aadarshkumar-singh/movementdetectionusingradar/20_SW/Workspace_SDHD_FreeSoc2/SDHD_MovementDetection.cydsn/docs/hardware_setup.jpg

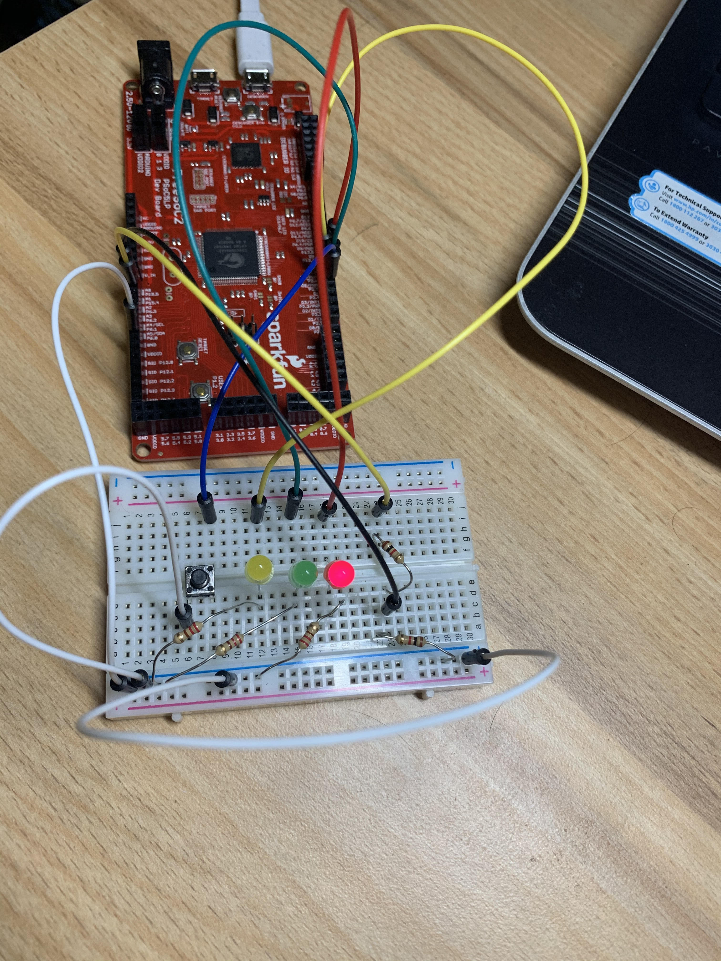
20_SW/Workspace_SDHD_FreeSoc2/SDHD_MovementDetection.cydsn/docs/hardware_setup.jpg
