aadarshkumar-singh/movementdetectionusingradar/60_Report/part_3_implementing_on_hardware/3D_SideView.png

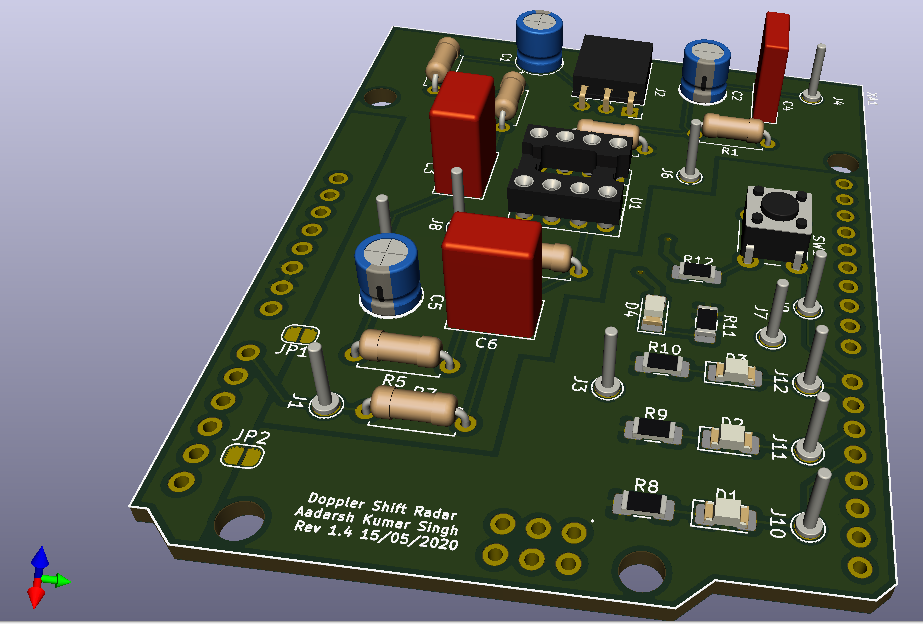
60_Report/part_3_implementing_on_hardware/3D_SideView.png
