aadarshkumar-singh/movementdetectionusingradar/60_Report/part_2_Software_Assignment/Statemachine.pdf

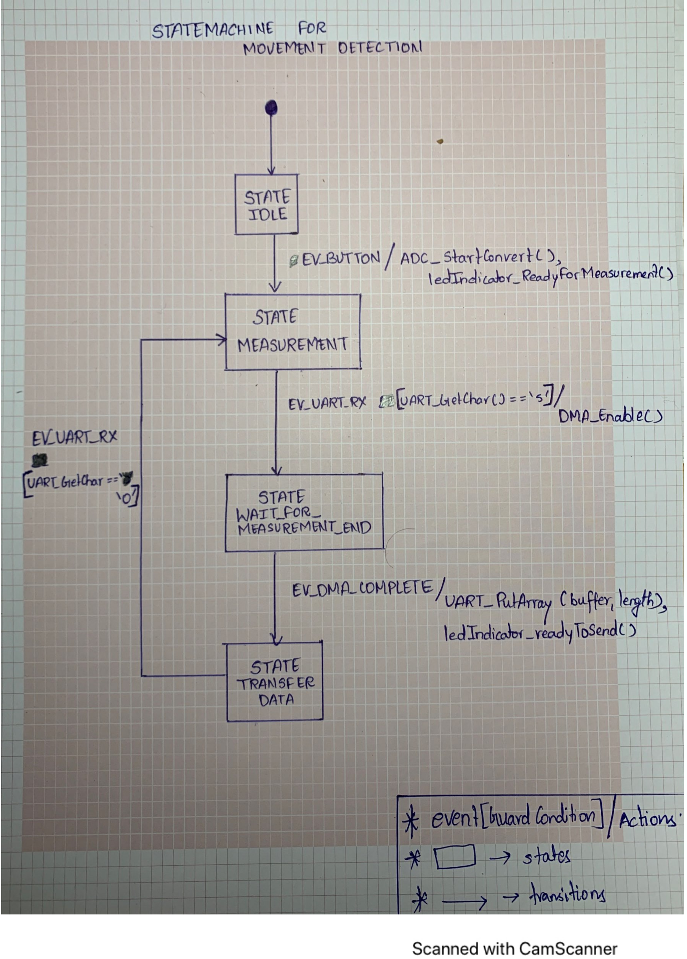
[picture p13: page 1]
