aadarshkumar-singh/movementdetectionusingradar/20_SW/Workspace_SDHD_FreeSoc2/SDHD_MovementDetection.cydsn/matlab/screenshots/Improvement/_Vout2_autoIncrement_f_100Hz.png

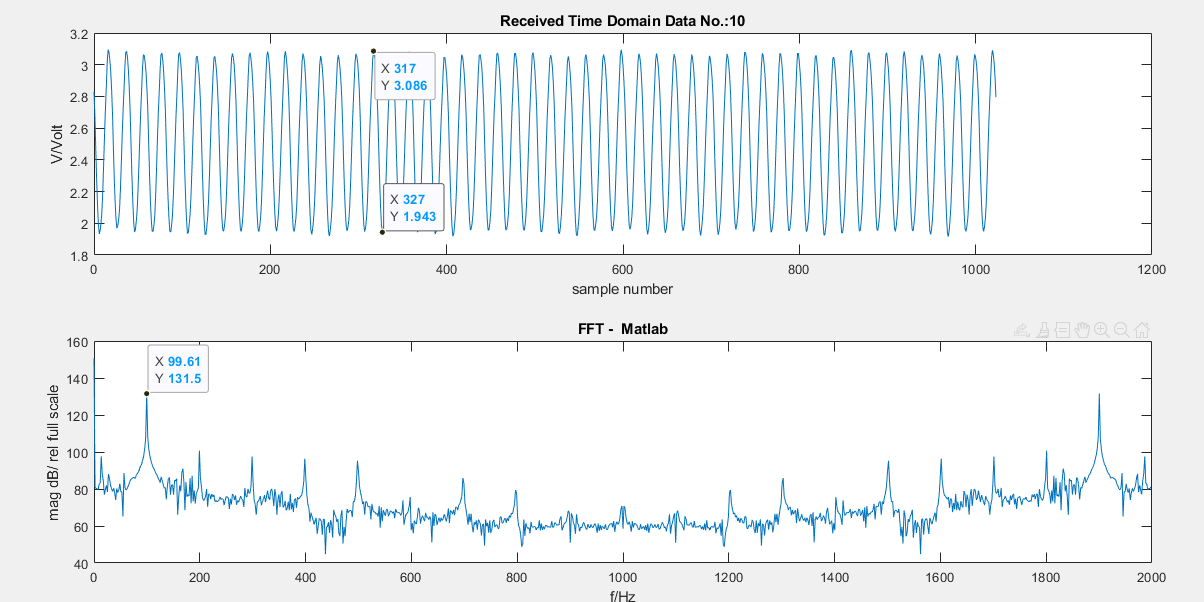
20_SW/Workspace_SDHD_FreeSoc2/SDHD_MovementDetection.cydsn/matlab/screenshots/Improvement/_Vout2_autoIncrement_f_100Hz.png
