aadarshkumar-singh/movementdetectionusingradar/20_SW/Workspace_SDHD_FreeSoc2/SDHD_MovementDetection.cydsn/matlab/screenshots/Improvement/Vout2_autoIncrement_f_50Hz.png

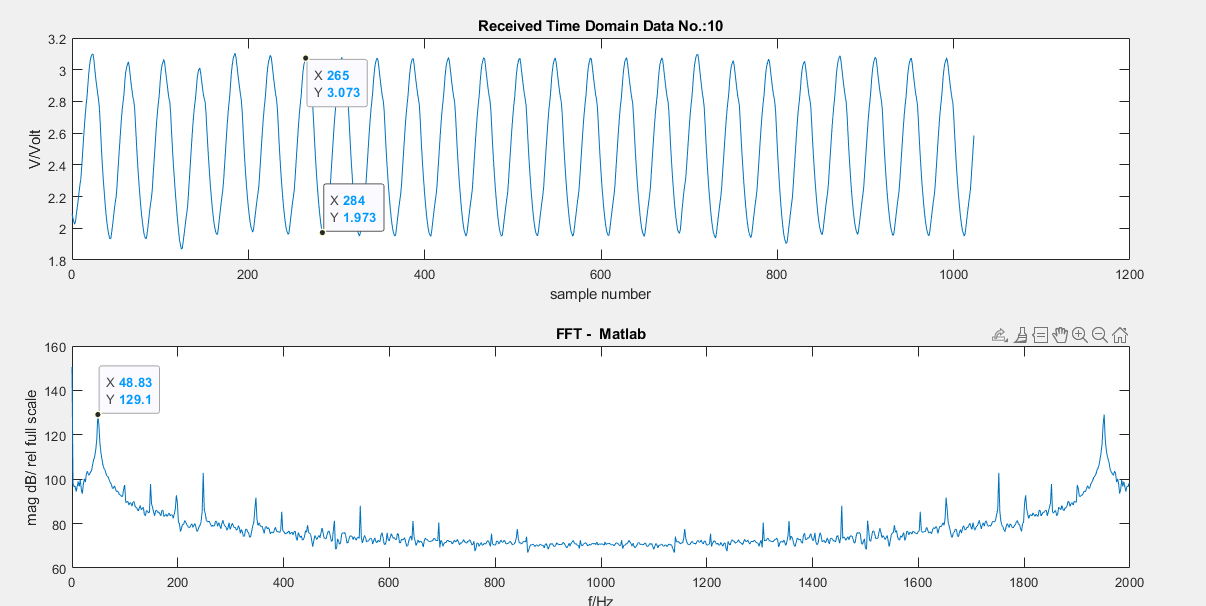
20_SW/Workspace_SDHD_FreeSoc2/SDHD_MovementDetection.cydsn/matlab/screenshots/Improvement/Vout2_autoIncrement_f_50Hz.png
