aadarshkumar-singh/movementdetectionusingradar/20_SW/Workspace_SDHD_FreeSoc2/SDHD_MovementDetection.cydsn/matlab/screenshots/VppForSignals_F_100Hz_Vin_40mV/VinPPValue.png

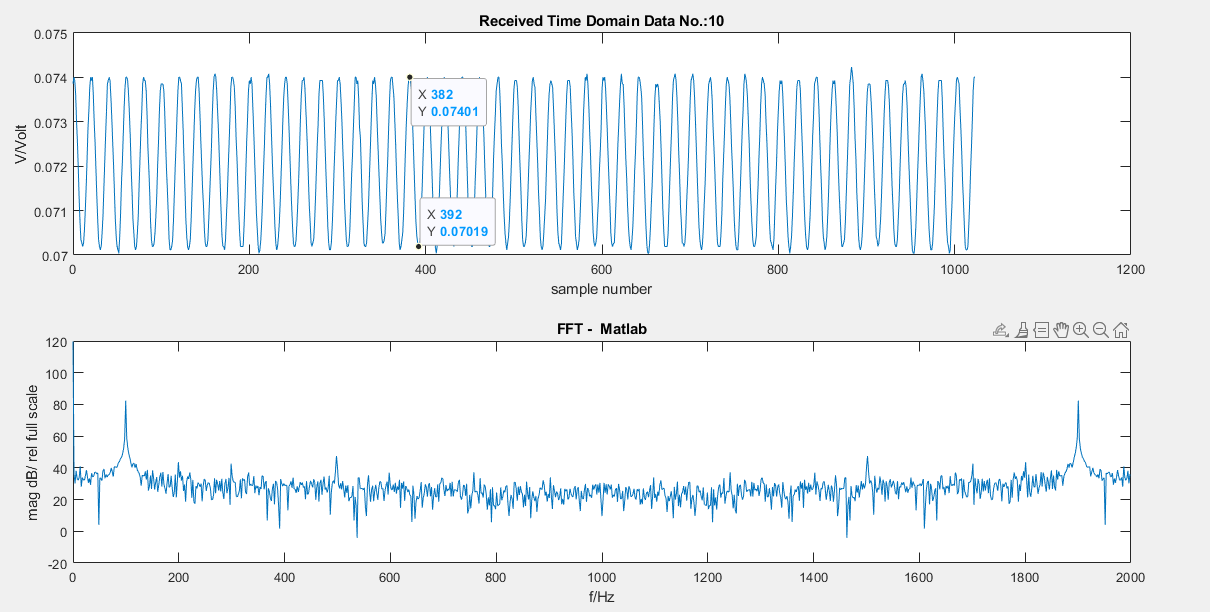
20_SW/Workspace_SDHD_FreeSoc2/SDHD_MovementDetection.cydsn/matlab/screenshots/VppForSignals_F_100Hz_Vin_40mV/VinPPValue.png
