aadarshkumar-singh/movementdetectionusingradar/60_Report/part_3_implementing_on_hardware/pcb_layout.png

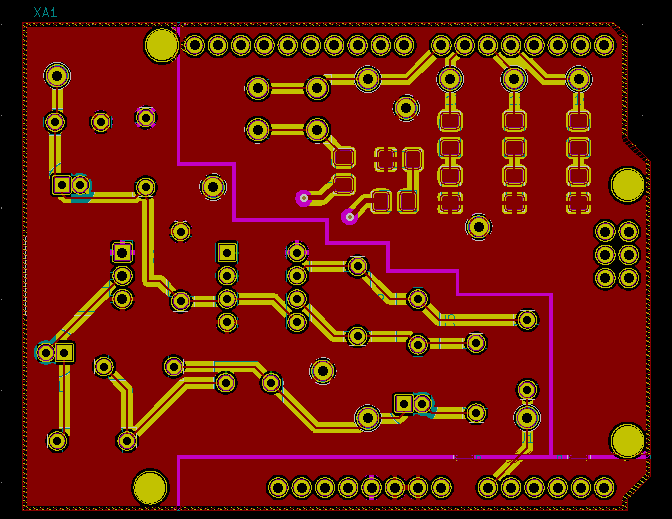
60_Report/part_3_implementing_on_hardware/pcb_layout.png
