aadarshkumar-singh/movementdetectionusingradar/50_Output/Testbench_Vout2pp_diffFreq/_Vout2_autoIncrement_f_150Hz.png

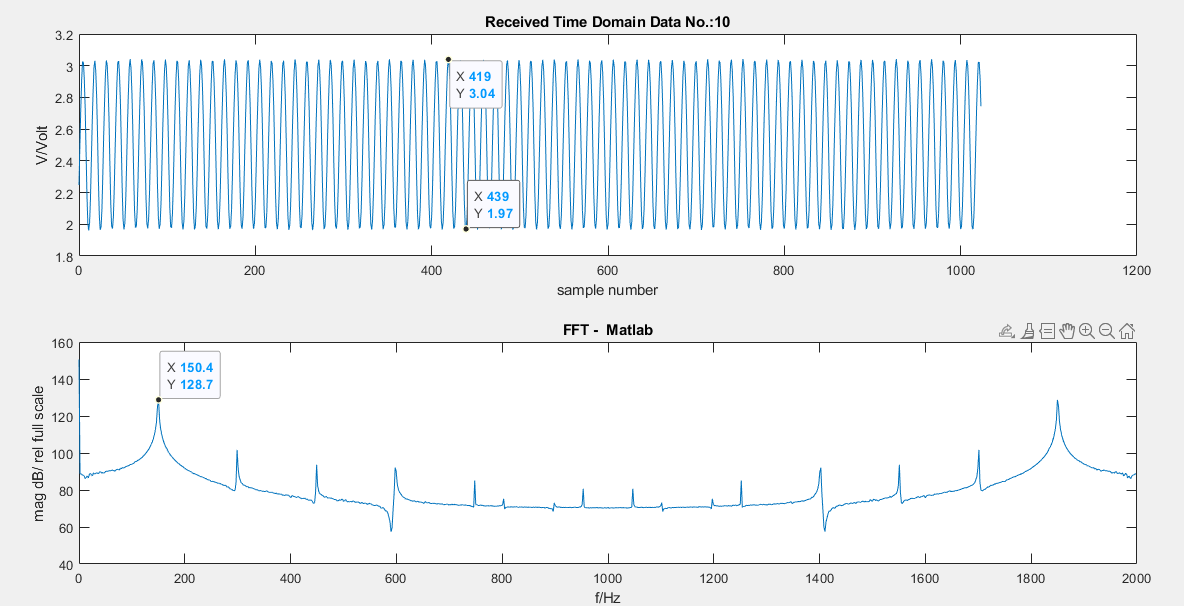
50_Output/Testbench_Vout2pp_diffFreq/_Vout2_autoIncrement_f_150Hz.png
