aadarshkumar-singh/movementdetectionusingradar/50_Output/Testbench_Vout2pp_diffFreq/Vout2_autoIncrement_f_600Hz.png

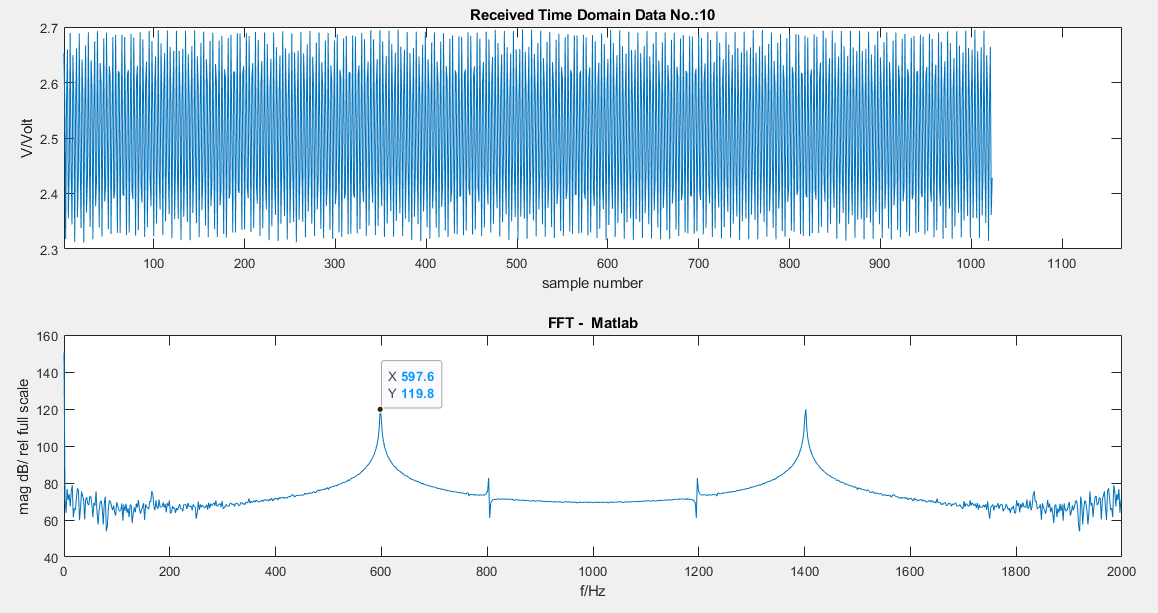
50_Output/Testbench_Vout2pp_diffFreq/Vout2_autoIncrement_f_600Hz.png
