aadarshkumar-singh/movementdetectionusingradar/30_SW_improve_autoFreqChange/SDHD_MovementDetection.cydsn/CortexM3/ARM_GCC_541/Debug/LINK_options.txt

-Wl,--start-group -o "C:\\aadarshxp\\_MastersEmbeddedSystem\\Semester-2\\SystemLevelHardwareDesign\\movement_detection_using_radar\\40_Implementation\\work\\30_SW_improve_autoFreqChange\\SDHD_MovementDetection.cydsn\\CortexM3\\ARM_GCC_541\\Debug\\SDHD_MovementDetection.elf" ".\\CortexM3\\ARM_GCC_541\\Debug\\main.o" ".\\CortexM3\\ARM_GCC_541\\Debug\\movementDetector.o" ".\\CortexM3\\ARM_GCC_541\\Debug\\dma.o" ".\\CortexM3\\ARM_GCC_541\\Debug\\led.o" ".\\CortexM3\\ARM_GCC_541\\Debug\\cyfitter_cfg.o" ".\\CortexM3\\ARM_GCC_541\\Debug\\cymetadata.o" ".\\CortexM3\\ARM_GCC_541\\Debug\\Cm3Start.o" ".\\CortexM3\\ARM_GCC_541\\Debug\\SDHD_MovementDetection.a" "C:\\Program\ Files\ (x86)\\Cypress\\PSoC\ Creator\\4.3\\PSoC\ Creator\\psoc\\content\\cycomponentlibrary\\CyComponentLibrary.cylib\\CortexM3\\ARM_GCC_541\\Debug\\CyComponentLibrary.a" -mcpu=cortex-m3 -mthumb -L "Generated_Source\\PSoC5" "-Wl,-Map,.\\CortexM3\\ARM_GCC_541\\Debug/SDHD_MovementDetection.map" -T "Generated_Source\\PSoC5\\cm3gcc.ld" -specs=nano.specs -Wl,--gc-sections -g -ffunction-sections -Og -ffat-lto-objects -Wl,--end-group
