aadarshkumar-singh/movementdetectionusingradar/10_HW/30_PCB/DopplerShiftRadarModule.kicad_pcb

## KiCad design 10_HW/30_PCB/DopplerShiftRadarModule.kicad_pcb (2021-11-08)

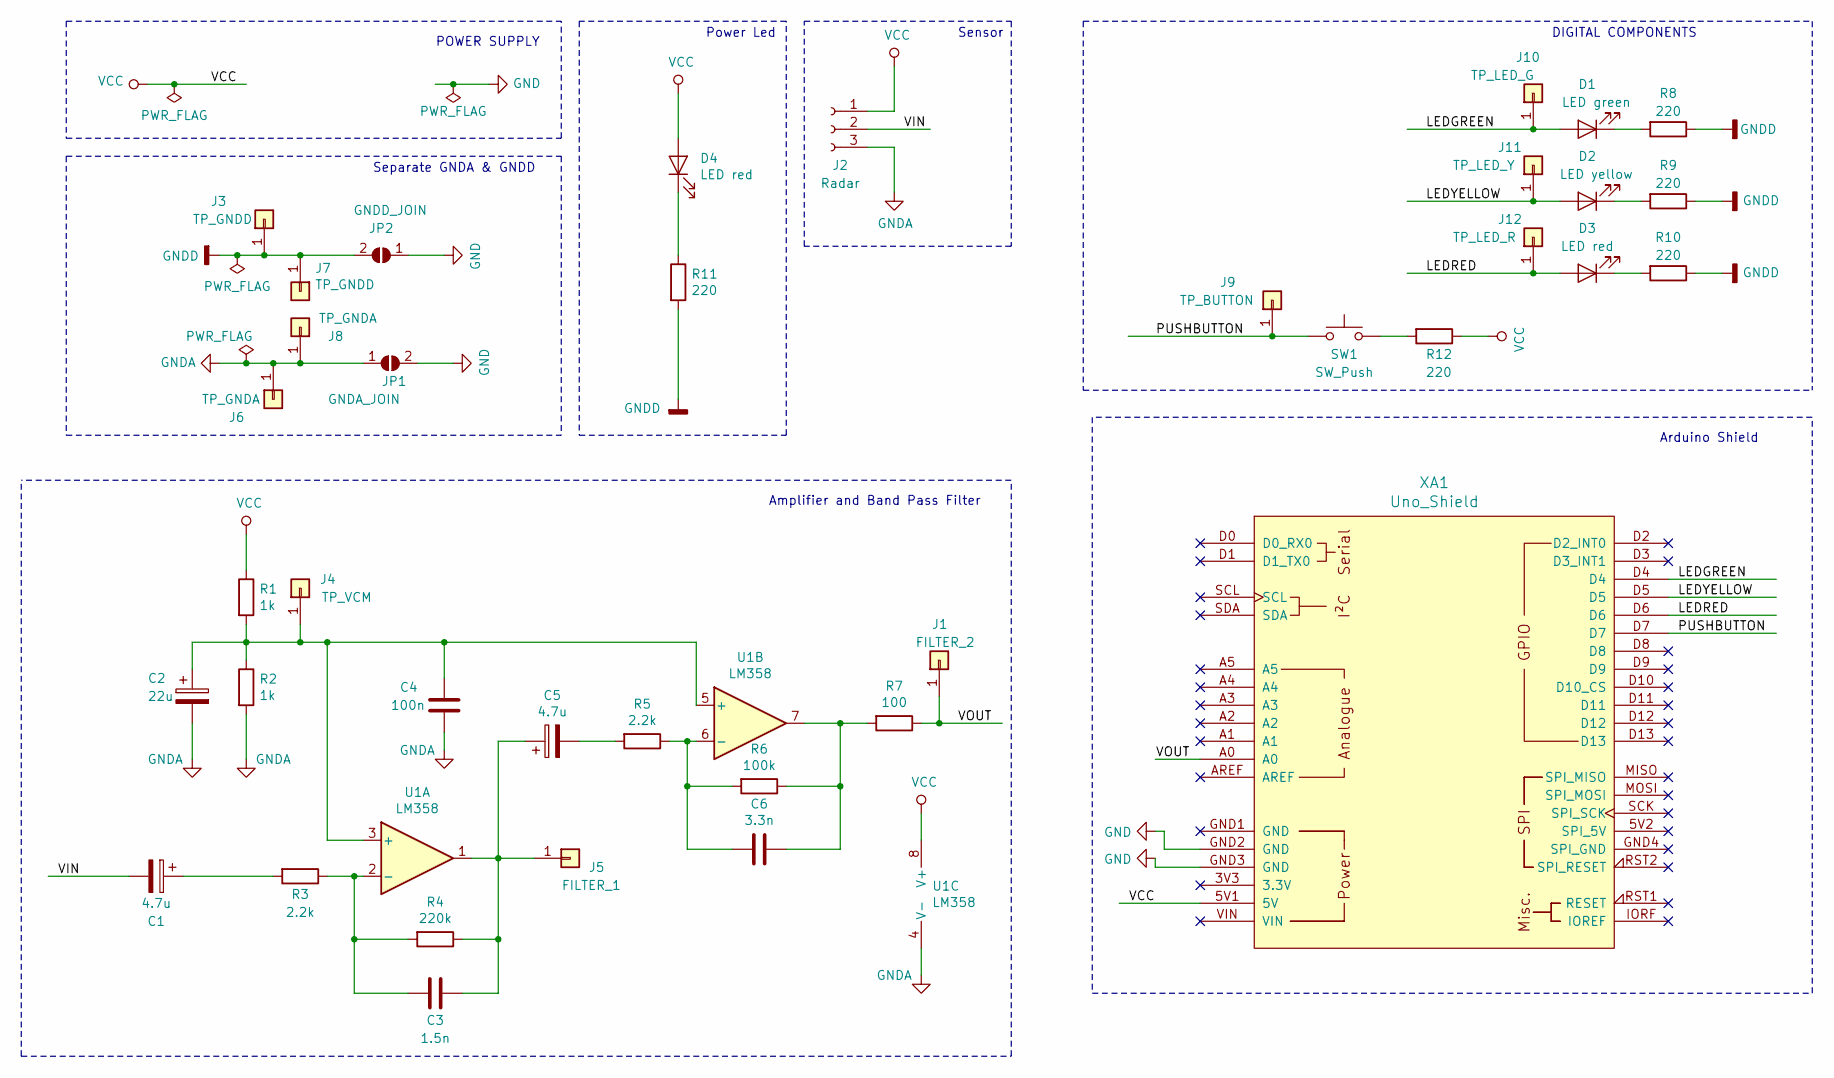
[picture p31: schematic DopplerShiftRadarModule.sch, Dopplershift Radar Module]

Parts:
C1, C5: 4.7u; CP_Radial_D5.0mm_P2.00mm
C2: 22u; CP_Radial_D5.0mm_P2.00mm
C3: 1.5n; C_Rect_L7.2mm_W4.5mm_P5.00mm_FKS2_FKP2_MKS2_MKP2
C4: 100n; C_Rect_L7.2mm_W2.5mm_P5.00mm_FKS2_FKP2_MKS2_MKP2
C6: 3.3n; C_Rect_L7.2mm_W4.5mm_P5.00mm_FKS2_FKP2_MKS2_MKP2
D1: LED green; LED_1206_3216Metric_Pad1.42x1.75mm_HandSolder
D2: LED yellow; LED_1206_3216Metric_Pad1.42x1.75mm_HandSolder
D3, D4: LED red; LED_1206_3216Metric_Pad1.42x1.75mm_HandSolder
J1: FILTER_2; Pin_D1.0mm_L10.0mm
J2: Radar; PinSocket_1x03_P2.54mm_Horizontal
J3, J7: TP_GNDD; Pin_D1.0mm_L10.0mm
J4: TP_VCM; Pin_D1.0mm_L10.0mm
J5: FILTER_1; Pin_D1.0mm_L10.0mm
J6, J8: TP_GNDA; Pin_D1.0mm_L10.0mm
J9: TP_BUTTON; Pin_D1.0mm_L10.0mm
J10: TP_LED_G; Pin_D1.0mm_L10.0mm
J11: TP_LED_Y; Pin_D1.0mm_L10.0mm
J12: TP_LED_R; Pin_D1.0mm_L10.0mm
JP1: GNDA_JOIN; SolderJumper-2_P1.3mm_Open_RoundedPad1.0x1.5mm
JP2: GNDD_JOIN; SolderJumper-2_P1.3mm_Open_RoundedPad1.0x1.5mm
R1, R2: 1k; R_Axial_DIN0207_L6.3mm_D2.5mm_P7.62mm_Horizontal
R3, R5: 2.2k; R_Axial_DIN0207_L6.3mm_D2.5mm_P7.62mm_Horizontal
R4: 220k; R_Axial_DIN0207_L6.3mm_D2.5mm_P7.62mm_Horizontal
R6: 100k; R_Axial_DIN0207_L6.3mm_D2.5mm_P7.62mm_Horizontal
R7: 100; R_Axial_DIN0207_L6.3mm_D2.5mm_P7.62mm_Horizontal
R8, R9, R10, R11, R12: 220; R_1206_3216Metric_Pad1.42x1.75mm_HandSolder
SW1: SW_Push; SW_PUSH_6mm_H4.3mm
U1: LM358; DIP-8_W7.62mm_Socket
XA1: Uno_Shield; Arduino_Uno_Shield

Connections:
/LEDGREEN: D1.2 (A), J10.1, XA1.D4
/LEDRED: D3.2 (A), J12.1, XA1.D6
/LEDYELLOW: D2.2 (A), J11.1, XA1.D5
/PUSHBUTTON: J9.1, SW1.1, XA1.D7
/VIN: C1.2, J2.2
/VOUT: J1.1, R7.1, XA1.A0
GND: JP1.2 (B), JP2.1 (A), XA1.GND2 (GND), XA1.GND3 (GND)
GNDA: C2.2, C4.2, J2.3, J6.1, J8.1, JP1.1 (A), R2.2, U1.4 (V-)
GNDD: J3.1, J7.1, JP2.2 (B), R8.1, R9.1, R10.1, R11.2
unnamed: C1.1, R3.2
unnamed: C2.1, C4.1, J4.1, R1.2, R2.1, U1.3 (+), U1.5 (+)
unnamed: C3.1, C5.1, J5.1, R4.1, U1.1
unnamed: C3.2, R3.1, R4.2, U1.2 (-)
unnamed: C5.2, R5.2
unnamed: C6.1, R6.1, R7.2, U1.7
unnamed: C6.2, R5.1, R6.2, U1.6 (-)
unnamed: D1.1 (K), R8.2
unnamed: D2.1 (K), R9.2
unnamed: D3.1 (K), R10.2
unnamed: D4.1 (K), R11.1
unnamed: R12.2, SW1.2
VCC: D4.2 (A), J2.1, R1.1, R12.1, U1.8 (V+), XA1.5V1 (5V)

Notes on the sheet:
Amplifier and Band Pass Filter
Separate GNDA & GNDD
Sensor
Power Led
Arduino Shield
DIGITAL COMPONENTS
POWER SUPPLY

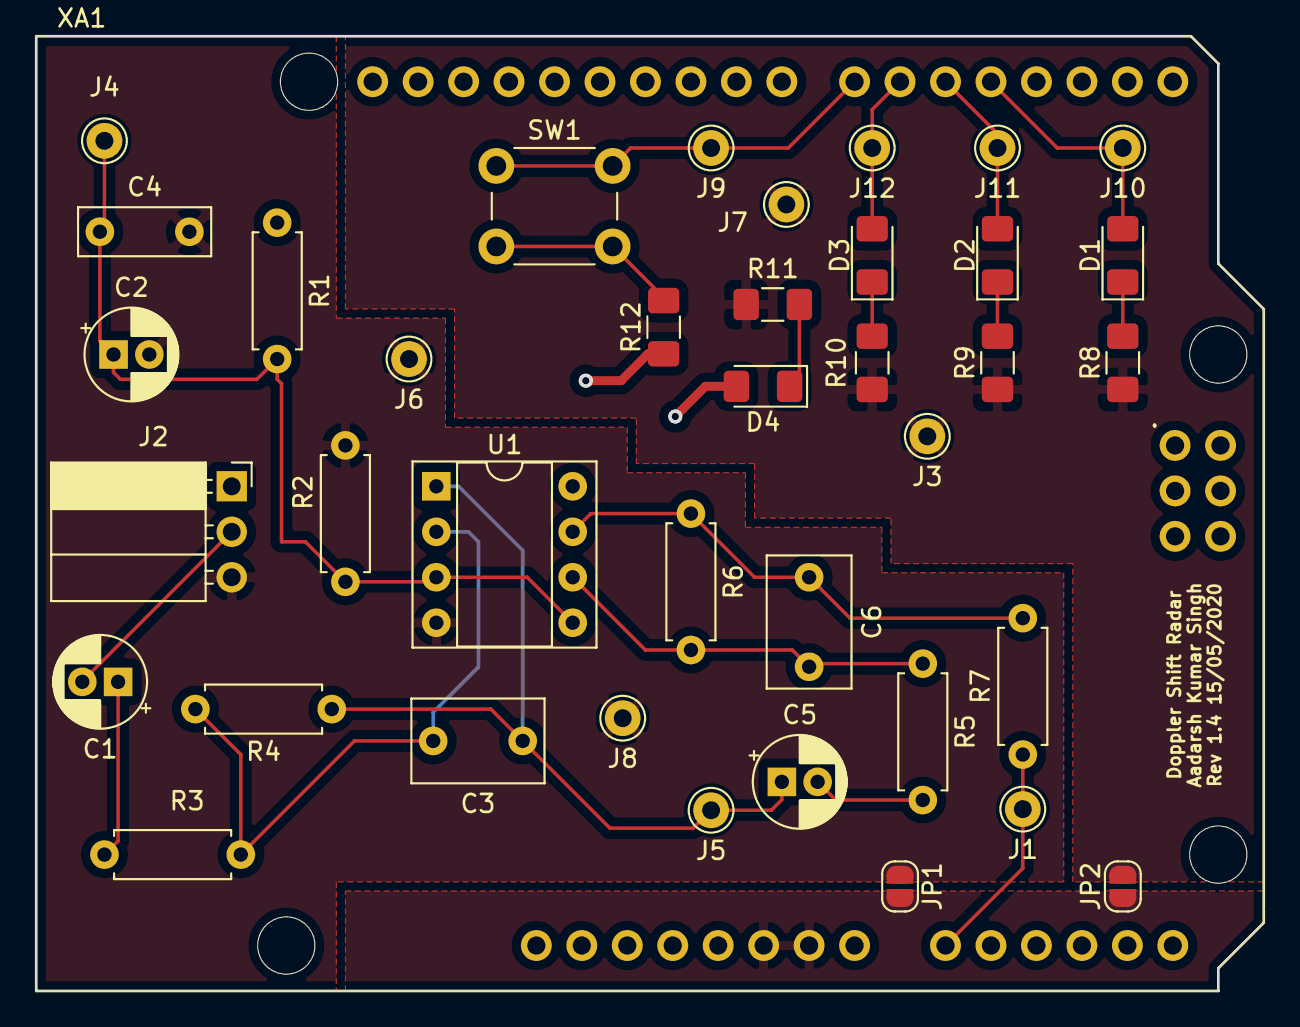
[picture p32: board DopplerShiftRadarModule.kicad_pcb from above]

Board: 4 copper layers, 68.6 x 53.3 mm, 39 parts (0 on the bottom side), 22 nets.
