aadarshkumar-singh/movementdetectionusingradar/30_SW_improve_autoFreqChange/SDHD_MovementDetection.cydsn/codegentemp/MuxControlRegister.h

/*******************************************************************************
* File Name: MuxControlRegister.h  
* Version 1.80
*
* Description:
*  This file containts Control Register function prototypes and register defines
*
* Note:
*
********************************************************************************
* Copyright 2008-2015, Cypress Semiconductor Corporation.  All rights reserved.
* You may use this file only in accordance with the license, terms, conditions, 
* disclaimers, and limitations in the end user license agreement accompanying 
* the software package with which this file was provided.
*******************************************************************************/

#if !defined(CY_CONTROL_REG_MuxControlRegister_H) /* CY_CONTROL_REG_MuxControlRegister_H */
#define CY_CONTROL_REG_MuxControlRegister_H

#include "cyfitter.h"

#if ((CYDEV_CHIP_FAMILY_USED == CYDEV_CHIP_FAMILY_PSOC3) || \
     (CYDEV_CHIP_FAMILY_USED == CYDEV_CHIP_FAMILY_PSOC4) || \
     (CYDEV_CHIP_FAMILY_USED == CYDEV_CHIP_FAMILY_PSOC5))
    #include "cytypes.h"
#else
    #include "syslib/cy_syslib.h"
#endif

    
/***************************************
*     Data Struct Definitions
***************************************/

/* Sleep Mode API Support */
typedef struct
{
    uint8 controlState;

} MuxControlRegister_BACKUP_STRUCT;


/***************************************
*         Function Prototypes 
***************************************/

void    MuxControlRegister_Write(uint8 control) ;
uint8   MuxControlRegister_Read(void) ;

void MuxControlRegister_SaveConfig(void) ;
void MuxControlRegister_RestoreConfig(void) ;
void MuxControlRegister_Sleep(void) ; 
void MuxControlRegister_Wakeup(void) ;


/***************************************
*            Registers        
***************************************/

/* Control Register */
#define MuxControlRegister_Control        (* (reg8 *) MuxControlRegister_Sync_ctrl_reg__CONTROL_REG )
#define MuxControlRegister_Control_PTR    (  (reg8 *) MuxControlRegister_Sync_ctrl_reg__CONTROL_REG )

#endif /* End CY_CONTROL_REG_MuxControlRegister_H */


/* [] END OF FILE */
