aadarshkumar-singh/movementdetectionusingradar/20_SW/Workspace_SDHD_FreeSoc2/SDHD_MovementDetection.cydsn/codegentemp/WaveDAC.c

/*******************************************************************************
* File Name: WaveDAC.c
* Version 2.10
*
* Description:
*  This file provides the source code for the 8-bit Waveform DAC 
*  (WaveDAC8) Component.
*
********************************************************************************
* Copyright 2013, Cypress Semiconductor Corporation.  All rights reserved.
* You may use this file only in accordance with the license, terms, conditions,
* disclaimers, and limitations in the end user license agreement accompanying
* the software package with which this file was provided.
*******************************************************************************/

#include "WaveDAC.h"

uint8  WaveDAC_initVar = 0u;

const uint8 CYCODE WaveDAC_wave1[WaveDAC_WAVE1_LENGTH] = { 128u,128u,128u,128u,129u,129u,129u,130u,130u,130u,130u,131u,131u,131u,131u,132u,132u,132u,132u,132u,132u,132u,132u,132u,132u,132u,132u,132u,132u,132u,132u,132u,132u,132u,132u,132u,131u,131u,131u,131u,130u,130u,130u,130u,129u,129u,129u,128u,128u,128u,128u,127u,127u,127u,126u,126u,126u,125u,125u,125u,125u,124u,124u,124u,124u,123u,123u,123u,123u,123u,123u,123u,123u,123u,123u,122u,123u,123u,123u,123u,123u,123u,123u,123u,123u,123u,124u,124u,124u,124u,125u,125u,125u,125u,126u,126u,126u,127u,127u,127u };
const uint8 CYCODE WaveDAC_wave2[WaveDAC_WAVE2_LENGTH] = { 252u,252u,252u,252u,252u,252u,252u,252u,252u,252u,252u,252u,252u,252u,252u,252u,252u,252u,252u,252u,252u,252u,252u,252u,252u,252u,252u,252u,252u,252u,252u,252u,252u,252u,252u,252u,252u,252u,252u,252u,252u,252u,252u,252u,252u,252u,252u,252u,252u,252u,3u,3u,3u,3u,3u,3u,3u,3u,3u,3u,3u,3u,3u,3u,3u,3u,3u,3u,3u,3u,3u,3u,3u,3u,3u,3u,3u,3u,3u,3u,3u,3u,3u,3u,3u,3u,3u,3u,3u,3u,3u,3u,3u,3u,3u,3u,3u,3u,3u,3u };

static uint8  WaveDAC_Wave1Chan;
static uint8  WaveDAC_Wave2Chan;
static uint8  WaveDAC_Wave1TD;
static uint8  WaveDAC_Wave2TD;


/*******************************************************************************
* Function Name: WaveDAC_Init
********************************************************************************
*
* Summary:
*  Initializes component with parameters set in the customizer.
*
* Parameters:  
*  None
*
* Return: 
*  None
*
*******************************************************************************/
void WaveDAC_Init(void) 
{
	WaveDAC_VDAC8_Init();
	WaveDAC_VDAC8_SetSpeed(WaveDAC_HIGHSPEED);
	WaveDAC_VDAC8_SetRange(WaveDAC_DAC_RANGE);

	#if(WaveDAC_DAC_MODE == WaveDAC_CURRENT_MODE)
		WaveDAC_IDAC8_SetPolarity(WaveDAC_DAC_POL);
	#endif /* WaveDAC_DAC_MODE == WaveDAC_CURRENT_MODE */

	#if(WaveDAC_OUT_MODE == WaveDAC_BUFFER_MODE)
	   WaveDAC_BuffAmp_Init();
	#endif /* WaveDAC_OUT_MODE == WaveDAC_BUFFER_MODE */

	/* Get the TD Number for the DMA channel 1 and 2   */
	WaveDAC_Wave1TD = CyDmaTdAllocate();
	WaveDAC_Wave2TD = CyDmaTdAllocate();
	
	/* Initialize waveform pointers  */
	WaveDAC_Wave1Setup(WaveDAC_wave1, WaveDAC_WAVE1_LENGTH) ;
	WaveDAC_Wave2Setup(WaveDAC_wave2, WaveDAC_WAVE2_LENGTH) ;
	
	/* Initialize the internal clock if one present  */
	#if defined(WaveDAC_DacClk_PHASE)
	   WaveDAC_DacClk_SetPhase(WaveDAC_CLK_PHASE_0nS);
	#endif /* defined(WaveDAC_DacClk_PHASE) */
}


/*******************************************************************************
* Function Name: WaveDAC_Enable
********************************************************************************
*  
* Summary: 
*  Enables the DAC block and DMA operation.
*
* Parameters:  
*  None
*
* Return: 
*  None
*
*******************************************************************************/
void WaveDAC_Enable(void) 
{
	WaveDAC_VDAC8_Enable();

	#if(WaveDAC_OUT_MODE == WaveDAC_BUFFER_MODE)
	   WaveDAC_BuffAmp_Enable();
	#endif /* WaveDAC_OUT_MODE == WaveDAC_BUFFER_MODE */

	/* 
	* Enable the channel. It is configured to remember the TD value so that
	* it can be restored from the place where it has been stopped.
	*/
	(void)CyDmaChEnable(WaveDAC_Wave1Chan, 1u);
	(void)CyDmaChEnable(WaveDAC_Wave2Chan, 1u);
	
	/* set the initial value */
	WaveDAC_SetValue(0u);
	
	#if(WaveDAC_CLOCK_SRC == WaveDAC_CLOCK_INT)  	
	   WaveDAC_DacClk_Start();
	#endif /* WaveDAC_CLOCK_SRC == WaveDAC_CLOCK_INT */
}


/*******************************************************************************
* Function Name: WaveDAC_Start
********************************************************************************
*
* Summary:
*  The start function initializes the voltage DAC with the default values, 
*  and sets the power to the given level.  A power level of 0, is the same as 
*  executing the stop function.
*
* Parameters:  
*  None
*
* Return: 
*  None
*
* Reentrant:
*  No
*
*******************************************************************************/
void WaveDAC_Start(void) 
{
	/* If not Initialized then initialize all required hardware and software */
	if(WaveDAC_initVar == 0u)
	{
		WaveDAC_Init();
		WaveDAC_initVar = 1u;
	}
	
	WaveDAC_Enable();
}


/*******************************************************************************
* Function Name: WaveDAC_StartEx
********************************************************************************
*
* Summary:
*  The StartEx function sets pointers and sizes for both waveforms
*  and then starts the component.
*
* Parameters:  
*   uint8 * wavePtr1:     Pointer to the waveform 1 array.
*   uint16  sampleSize1:  The amount of samples in the waveform 1.
*   uint8 * wavePtr2:     Pointer to the waveform 2 array.
*   uint16  sampleSize2:  The amount of samples in the waveform 2.
*
* Return: 
*  None
*
* Reentrant:
*  No
*
*******************************************************************************/
void WaveDAC_StartEx(const uint8 * wavePtr1, uint16 sampleSize1, const uint8 * wavePtr2, uint16 sampleSize2)

{
	WaveDAC_Wave1Setup(wavePtr1, sampleSize1);
	WaveDAC_Wave2Setup(wavePtr2, sampleSize2);
	WaveDAC_Start();
}


/*******************************************************************************
* Function Name: WaveDAC_Stop
********************************************************************************
*
* Summary:
*  Stops the clock (if internal), disables the DMA channels
*  and powers down the DAC.
*
* Parameters:  
*  None  
*
* Return: 
*  None
*
*******************************************************************************/
void WaveDAC_Stop(void) 
{
	/* Turn off internal clock, if one present */
	#if(WaveDAC_CLOCK_SRC == WaveDAC_CLOCK_INT)  	
	   WaveDAC_DacClk_Stop();
	#endif /* WaveDAC_CLOCK_SRC == WaveDAC_CLOCK_INT */
	
	/* Disble DMA channels */
	(void)CyDmaChDisable(WaveDAC_Wave1Chan);
	(void)CyDmaChDisable(WaveDAC_Wave2Chan);

	/* Disable power to DAC */
	WaveDAC_VDAC8_Stop();
}


/*******************************************************************************
* Function Name: WaveDAC_Wave1Setup
********************************************************************************
*
* Summary:
*  Sets pointer and size for waveform 1.                                    
*
* Parameters:  
*  uint8 * WavePtr:     Pointer to the waveform array.
*  uint16  SampleSize:  The amount of samples in the waveform.
*
* Return: 
*  None 
*
*******************************************************************************/
void WaveDAC_Wave1Setup(const uint8 * wavePtr, uint16 sampleSize)

{
	#if (CY_PSOC3)
		uint16 memoryType; /* determining the source memory type */
		memoryType = (WaveDAC_HI16FLASHPTR == HI16(wavePtr)) ? HI16(CYDEV_FLS_BASE) : HI16(CYDEV_SRAM_BASE);
		
		WaveDAC_Wave1Chan = WaveDAC_Wave1_DMA_DmaInitialize(
		WaveDAC_Wave1_DMA_BYTES_PER_BURST, WaveDAC_Wave1_DMA_REQUEST_PER_BURST,
		memoryType, HI16(CYDEV_PERIPH_BASE));
	#else /* PSoC 5 */
		WaveDAC_Wave1Chan = WaveDAC_Wave1_DMA_DmaInitialize(
		WaveDAC_Wave1_DMA_BYTES_PER_BURST, WaveDAC_Wave1_DMA_REQUEST_PER_BURST,
		HI16(wavePtr), HI16(WaveDAC_DAC8__D));
	#endif /* CY_PSOC3 */
	
	/*
	* TD is looping on itself. 
    * Increment the source address, but not the destination address. 
	*/
	(void)CyDmaTdSetConfiguration(WaveDAC_Wave1TD, sampleSize, WaveDAC_Wave1TD, 
                                    (uint8)CY_DMA_TD_INC_SRC_ADR | (uint8)WaveDAC_Wave1_DMA__TD_TERMOUT_EN); 
	
	/* Set the TD source and destination address */
	(void)CyDmaTdSetAddress(WaveDAC_Wave1TD, LO16((uint32)wavePtr), LO16(WaveDAC_DAC8__D));
	
	/* Associate the TD with the channel */
	(void)CyDmaChSetInitialTd(WaveDAC_Wave1Chan, WaveDAC_Wave1TD);
}


/*******************************************************************************
* Function Name: WaveDAC_Wave2Setup
********************************************************************************
*
* Summary:
*  Sets pointer and size for waveform 2.                                    
*
* Parameters:  
*  uint8 * WavePtr:     Pointer to the waveform array.
*  uint16  SampleSize:  The amount of samples in the waveform.
*
* Return: 
*  None
*
*******************************************************************************/
void WaveDAC_Wave2Setup(const uint8 * wavePtr, uint16 sampleSize)
 
{
	#if (CY_PSOC3)
		uint16 memoryType; /* determining the source memory type */
		memoryType = (WaveDAC_HI16FLASHPTR == HI16(wavePtr)) ? HI16(CYDEV_FLS_BASE) : HI16(CYDEV_SRAM_BASE);
			
		WaveDAC_Wave2Chan = WaveDAC_Wave2_DMA_DmaInitialize(
		WaveDAC_Wave2_DMA_BYTES_PER_BURST, WaveDAC_Wave2_DMA_REQUEST_PER_BURST,
		memoryType, HI16(CYDEV_PERIPH_BASE));
	#else /* PSoC 5 */
		WaveDAC_Wave2Chan = WaveDAC_Wave2_DMA_DmaInitialize(
		WaveDAC_Wave2_DMA_BYTES_PER_BURST, WaveDAC_Wave2_DMA_REQUEST_PER_BURST,
		HI16(wavePtr), HI16(WaveDAC_DAC8__D));
	#endif /* CY_PSOC3 */
	
	/*
	* TD is looping on itself. 
	* Increment the source address, but not the destination address. 
	*/
	(void)CyDmaTdSetConfiguration(WaveDAC_Wave2TD, sampleSize, WaveDAC_Wave2TD, 
                                    (uint8)CY_DMA_TD_INC_SRC_ADR | (uint8)WaveDAC_Wave2_DMA__TD_TERMOUT_EN); 
	
	/* Set the TD source and destination address */
	(void)CyDmaTdSetAddress(WaveDAC_Wave2TD, LO16((uint32)wavePtr), LO16(WaveDAC_DAC8__D));
	
	/* Associate the TD with the channel */
	(void)CyDmaChSetInitialTd(WaveDAC_Wave2Chan, WaveDAC_Wave2TD);
}


/* [] END OF FILE */
