aadarshkumar-singh/movementdetectionusingradar/30_SW_improve_autoFreqChange/SDHD_MovementDetection.cydsn/codegentemp/Clk_150KHz.h

/*******************************************************************************
* File Name: Clk_150KHz.h
* Version 2.20
*
*  Description:
*   Provides the function and constant definitions for the clock component.
*
*  Note:
*
********************************************************************************
* Copyright 2008-2012, Cypress Semiconductor Corporation.  All rights reserved.
* You may use this file only in accordance with the license, terms, conditions, 
* disclaimers, and limitations in the end user license agreement accompanying 
* the software package with which this file was provided.
*******************************************************************************/

#if !defined(CY_CLOCK_Clk_150KHz_H)
#define CY_CLOCK_Clk_150KHz_H

#include <cytypes.h>
#include <cyfitter.h>


/***************************************
* Conditional Compilation Parameters
***************************************/

/* Check to see if required defines such as CY_PSOC5LP are available */
/* They are defined starting with cy_boot v3.0 */
#if !defined (CY_PSOC5LP)
    #error Component cy_clock_v2_20 requires cy_boot v3.0 or later
#endif /* (CY_PSOC5LP) */


/***************************************
*        Function Prototypes
***************************************/

void Clk_150KHz_Start(void) ;
void Clk_150KHz_Stop(void) ;

#if(CY_PSOC3 || CY_PSOC5LP)
void Clk_150KHz_StopBlock(void) ;
#endif /* (CY_PSOC3 || CY_PSOC5LP) */

void Clk_150KHz_StandbyPower(uint8 state) ;
void Clk_150KHz_SetDividerRegister(uint16 clkDivider, uint8 restart) 
                                ;
uint16 Clk_150KHz_GetDividerRegister(void) ;
void Clk_150KHz_SetModeRegister(uint8 modeBitMask) ;
void Clk_150KHz_ClearModeRegister(uint8 modeBitMask) ;
uint8 Clk_150KHz_GetModeRegister(void) ;
void Clk_150KHz_SetSourceRegister(uint8 clkSource) ;
uint8 Clk_150KHz_GetSourceRegister(void) ;
#if defined(Clk_150KHz__CFG3)
void Clk_150KHz_SetPhaseRegister(uint8 clkPhase) ;
uint8 Clk_150KHz_GetPhaseRegister(void) ;
#endif /* defined(Clk_150KHz__CFG3) */

#define Clk_150KHz_Enable()                       Clk_150KHz_Start()
#define Clk_150KHz_Disable()                      Clk_150KHz_Stop()
#define Clk_150KHz_SetDivider(clkDivider)         Clk_150KHz_SetDividerRegister(clkDivider, 1u)
#define Clk_150KHz_SetDividerValue(clkDivider)    Clk_150KHz_SetDividerRegister((clkDivider) - 1u, 1u)
#define Clk_150KHz_SetMode(clkMode)               Clk_150KHz_SetModeRegister(clkMode)
#define Clk_150KHz_SetSource(clkSource)           Clk_150KHz_SetSourceRegister(clkSource)
#if defined(Clk_150KHz__CFG3)
#define Clk_150KHz_SetPhase(clkPhase)             Clk_150KHz_SetPhaseRegister(clkPhase)
#define Clk_150KHz_SetPhaseValue(clkPhase)        Clk_150KHz_SetPhaseRegister((clkPhase) + 1u)
#endif /* defined(Clk_150KHz__CFG3) */


/***************************************
*             Registers
***************************************/

/* Register to enable or disable the clock */
#define Clk_150KHz_CLKEN              (* (reg8 *) Clk_150KHz__PM_ACT_CFG)
#define Clk_150KHz_CLKEN_PTR          ((reg8 *) Clk_150KHz__PM_ACT_CFG)

/* Register to enable or disable the clock */
#define Clk_150KHz_CLKSTBY            (* (reg8 *) Clk_150KHz__PM_STBY_CFG)
#define Clk_150KHz_CLKSTBY_PTR        ((reg8 *) Clk_150KHz__PM_STBY_CFG)

/* Clock LSB divider configuration register. */
#define Clk_150KHz_DIV_LSB            (* (reg8 *) Clk_150KHz__CFG0)
#define Clk_150KHz_DIV_LSB_PTR        ((reg8 *) Clk_150KHz__CFG0)
#define Clk_150KHz_DIV_PTR            ((reg16 *) Clk_150KHz__CFG0)

/* Clock MSB divider configuration register. */
#define Clk_150KHz_DIV_MSB            (* (reg8 *) Clk_150KHz__CFG1)
#define Clk_150KHz_DIV_MSB_PTR        ((reg8 *) Clk_150KHz__CFG1)

/* Mode and source configuration register */
#define Clk_150KHz_MOD_SRC            (* (reg8 *) Clk_150KHz__CFG2)
#define Clk_150KHz_MOD_SRC_PTR        ((reg8 *) Clk_150KHz__CFG2)

#if defined(Clk_150KHz__CFG3)
/* Analog clock phase configuration register */
#define Clk_150KHz_PHASE              (* (reg8 *) Clk_150KHz__CFG3)
#define Clk_150KHz_PHASE_PTR          ((reg8 *) Clk_150KHz__CFG3)
#endif /* defined(Clk_150KHz__CFG3) */


/**************************************
*       Register Constants
**************************************/

/* Power manager register masks */
#define Clk_150KHz_CLKEN_MASK         Clk_150KHz__PM_ACT_MSK
#define Clk_150KHz_CLKSTBY_MASK       Clk_150KHz__PM_STBY_MSK

/* CFG2 field masks */
#define Clk_150KHz_SRC_SEL_MSK        Clk_150KHz__CFG2_SRC_SEL_MASK
#define Clk_150KHz_MODE_MASK          (~(Clk_150KHz_SRC_SEL_MSK))

#if defined(Clk_150KHz__CFG3)
/* CFG3 phase mask */
#define Clk_150KHz_PHASE_MASK         Clk_150KHz__CFG3_PHASE_DLY_MASK
#endif /* defined(Clk_150KHz__CFG3) */

#endif /* CY_CLOCK_Clk_150KHz_H */


/* [] END OF FILE */
