aadarshkumar-singh/movementdetectionusingradar/20_SW/Workspace_SDHD_FreeSoc2/SDHD_MovementDetection.cydsn/codegentemp/Debounce_Clock.h

/*******************************************************************************
* File Name: Debounce_Clock.h
* Version 2.20
*
*  Description:
*   Provides the function and constant definitions for the clock component.
*
*  Note:
*
********************************************************************************
* Copyright 2008-2012, Cypress Semiconductor Corporation.  All rights reserved.
* You may use this file only in accordance with the license, terms, conditions, 
* disclaimers, and limitations in the end user license agreement accompanying 
* the software package with which this file was provided.
*******************************************************************************/

#if !defined(CY_CLOCK_Debounce_Clock_H)
#define CY_CLOCK_Debounce_Clock_H

#include <cytypes.h>
#include <cyfitter.h>


/***************************************
* Conditional Compilation Parameters
***************************************/

/* Check to see if required defines such as CY_PSOC5LP are available */
/* They are defined starting with cy_boot v3.0 */
#if !defined (CY_PSOC5LP)
    #error Component cy_clock_v2_20 requires cy_boot v3.0 or later
#endif /* (CY_PSOC5LP) */


/***************************************
*        Function Prototypes
***************************************/

void Debounce_Clock_Start(void) ;
void Debounce_Clock_Stop(void) ;

#if(CY_PSOC3 || CY_PSOC5LP)
void Debounce_Clock_StopBlock(void) ;
#endif /* (CY_PSOC3 || CY_PSOC5LP) */

void Debounce_Clock_StandbyPower(uint8 state) ;
void Debounce_Clock_SetDividerRegister(uint16 clkDivider, uint8 restart) 
                                ;
uint16 Debounce_Clock_GetDividerRegister(void) ;
void Debounce_Clock_SetModeRegister(uint8 modeBitMask) ;
void Debounce_Clock_ClearModeRegister(uint8 modeBitMask) ;
uint8 Debounce_Clock_GetModeRegister(void) ;
void Debounce_Clock_SetSourceRegister(uint8 clkSource) ;
uint8 Debounce_Clock_GetSourceRegister(void) ;
#if defined(Debounce_Clock__CFG3)
void Debounce_Clock_SetPhaseRegister(uint8 clkPhase) ;
uint8 Debounce_Clock_GetPhaseRegister(void) ;
#endif /* defined(Debounce_Clock__CFG3) */

#define Debounce_Clock_Enable()                       Debounce_Clock_Start()
#define Debounce_Clock_Disable()                      Debounce_Clock_Stop()
#define Debounce_Clock_SetDivider(clkDivider)         Debounce_Clock_SetDividerRegister(clkDivider, 1u)
#define Debounce_Clock_SetDividerValue(clkDivider)    Debounce_Clock_SetDividerRegister((clkDivider) - 1u, 1u)
#define Debounce_Clock_SetMode(clkMode)               Debounce_Clock_SetModeRegister(clkMode)
#define Debounce_Clock_SetSource(clkSource)           Debounce_Clock_SetSourceRegister(clkSource)
#if defined(Debounce_Clock__CFG3)
#define Debounce_Clock_SetPhase(clkPhase)             Debounce_Clock_SetPhaseRegister(clkPhase)
#define Debounce_Clock_SetPhaseValue(clkPhase)        Debounce_Clock_SetPhaseRegister((clkPhase) + 1u)
#endif /* defined(Debounce_Clock__CFG3) */


/***************************************
*             Registers
***************************************/

/* Register to enable or disable the clock */
#define Debounce_Clock_CLKEN              (* (reg8 *) Debounce_Clock__PM_ACT_CFG)
#define Debounce_Clock_CLKEN_PTR          ((reg8 *) Debounce_Clock__PM_ACT_CFG)

/* Register to enable or disable the clock */
#define Debounce_Clock_CLKSTBY            (* (reg8 *) Debounce_Clock__PM_STBY_CFG)
#define Debounce_Clock_CLKSTBY_PTR        ((reg8 *) Debounce_Clock__PM_STBY_CFG)

/* Clock LSB divider configuration register. */
#define Debounce_Clock_DIV_LSB            (* (reg8 *) Debounce_Clock__CFG0)
#define Debounce_Clock_DIV_LSB_PTR        ((reg8 *) Debounce_Clock__CFG0)
#define Debounce_Clock_DIV_PTR            ((reg16 *) Debounce_Clock__CFG0)

/* Clock MSB divider configuration register. */
#define Debounce_Clock_DIV_MSB            (* (reg8 *) Debounce_Clock__CFG1)
#define Debounce_Clock_DIV_MSB_PTR        ((reg8 *) Debounce_Clock__CFG1)

/* Mode and source configuration register */
#define Debounce_Clock_MOD_SRC            (* (reg8 *) Debounce_Clock__CFG2)
#define Debounce_Clock_MOD_SRC_PTR        ((reg8 *) Debounce_Clock__CFG2)

#if defined(Debounce_Clock__CFG3)
/* Analog clock phase configuration register */
#define Debounce_Clock_PHASE              (* (reg8 *) Debounce_Clock__CFG3)
#define Debounce_Clock_PHASE_PTR          ((reg8 *) Debounce_Clock__CFG3)
#endif /* defined(Debounce_Clock__CFG3) */


/**************************************
*       Register Constants
**************************************/

/* Power manager register masks */
#define Debounce_Clock_CLKEN_MASK         Debounce_Clock__PM_ACT_MSK
#define Debounce_Clock_CLKSTBY_MASK       Debounce_Clock__PM_STBY_MSK

/* CFG2 field masks */
#define Debounce_Clock_SRC_SEL_MSK        Debounce_Clock__CFG2_SRC_SEL_MASK
#define Debounce_Clock_MODE_MASK          (~(Debounce_Clock_SRC_SEL_MSK))

#if defined(Debounce_Clock__CFG3)
/* CFG3 phase mask */
#define Debounce_Clock_PHASE_MASK         Debounce_Clock__CFG3_PHASE_DLY_MASK
#endif /* defined(Debounce_Clock__CFG3) */

#endif /* CY_CLOCK_Debounce_Clock_H */


/* [] END OF FILE */
