aadarshkumar-singh/movementdetectionusingradar/20_SW/Workspace_SDHD_FreeSoc2/SDHD_MovementDetection.cydsn/codegentemp/IRQ_DMA.h

/*******************************************************************************
* File Name: IRQ_DMA.h
* Version 1.70
*
*  Description:
*   Provides the function definitions for the Interrupt Controller.
*
*
********************************************************************************
* Copyright 2008-2015, Cypress Semiconductor Corporation.  All rights reserved.
* You may use this file only in accordance with the license, terms, conditions, 
* disclaimers, and limitations in the end user license agreement accompanying 
* the software package with which this file was provided.
*******************************************************************************/
#if !defined(CY_ISR_IRQ_DMA_H)
#define CY_ISR_IRQ_DMA_H


#include <cytypes.h>
#include <cyfitter.h>

/* Interrupt Controller API. */
void IRQ_DMA_Start(void);
void IRQ_DMA_StartEx(cyisraddress address);
void IRQ_DMA_Stop(void);

CY_ISR_PROTO(IRQ_DMA_Interrupt);

void IRQ_DMA_SetVector(cyisraddress address);
cyisraddress IRQ_DMA_GetVector(void);

void IRQ_DMA_SetPriority(uint8 priority);
uint8 IRQ_DMA_GetPriority(void);

void IRQ_DMA_Enable(void);
uint8 IRQ_DMA_GetState(void);
void IRQ_DMA_Disable(void);

void IRQ_DMA_SetPending(void);
void IRQ_DMA_ClearPending(void);


/* Interrupt Controller Constants */

/* Address of the INTC.VECT[x] register that contains the Address of the IRQ_DMA ISR. */
#define IRQ_DMA_INTC_VECTOR            ((reg32 *) IRQ_DMA__INTC_VECT)

/* Address of the IRQ_DMA ISR priority. */
#define IRQ_DMA_INTC_PRIOR             ((reg8 *) IRQ_DMA__INTC_PRIOR_REG)

/* Priority of the IRQ_DMA interrupt. */
#define IRQ_DMA_INTC_PRIOR_NUMBER      IRQ_DMA__INTC_PRIOR_NUM

/* Address of the INTC.SET_EN[x] byte to bit enable IRQ_DMA interrupt. */
#define IRQ_DMA_INTC_SET_EN            ((reg32 *) IRQ_DMA__INTC_SET_EN_REG)

/* Address of the INTC.CLR_EN[x] register to bit clear the IRQ_DMA interrupt. */
#define IRQ_DMA_INTC_CLR_EN            ((reg32 *) IRQ_DMA__INTC_CLR_EN_REG)

/* Address of the INTC.SET_PD[x] register to set the IRQ_DMA interrupt state to pending. */
#define IRQ_DMA_INTC_SET_PD            ((reg32 *) IRQ_DMA__INTC_SET_PD_REG)

/* Address of the INTC.CLR_PD[x] register to clear the IRQ_DMA interrupt. */
#define IRQ_DMA_INTC_CLR_PD            ((reg32 *) IRQ_DMA__INTC_CLR_PD_REG)


#endif /* CY_ISR_IRQ_DMA_H */


/* [] END OF FILE */
