aadarshkumar-singh/movementdetectionusingradar/(notices)

Notices in the files:
20_SW/Workspace_SDHD_FreeSoc2/SDHD_MovementDetection.cydsn/source/bsw/global.h:
\copyright Copyright ©2016
Department of electrical engineering and information technology, Hochschule Darmstadt - University of applied sciences (h_da). All Rights Reserved.
